HarshHulke77/ESP32-Modbus-MQTT-Gateway/docs/captures/2026-10-23-tx-decoded.png

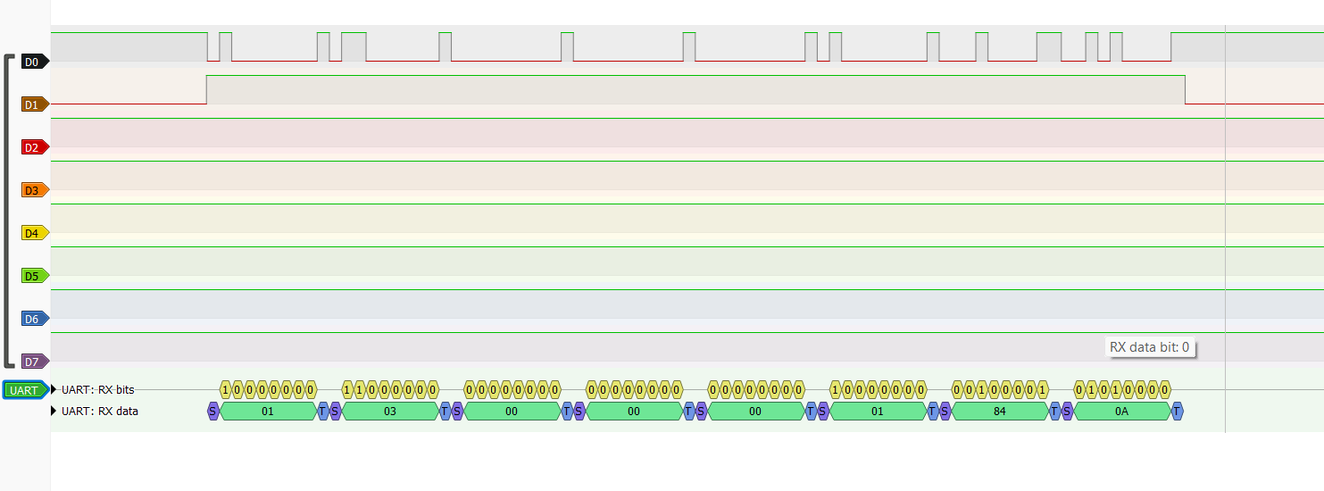
docs/captures/2026-10-23-tx-decoded.png
