HarshHulke77/ESP32-Modbus-MQTT-Gateway/docs/poll-capture1.png

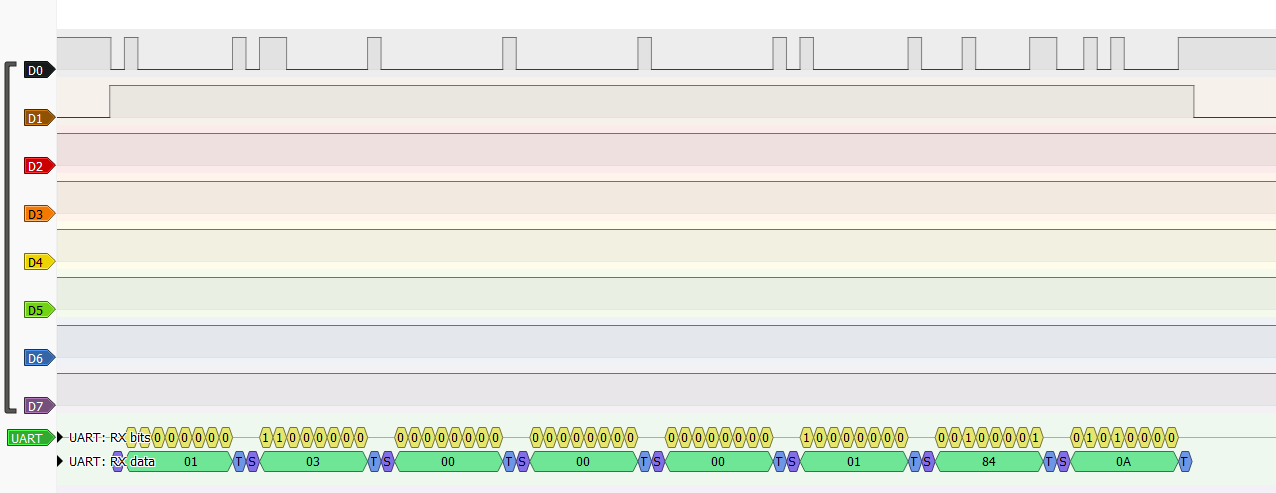
docs/poll-capture1.png
