HarshHulke77/ESP32-Modbus-MQTT-Gateway/docs/bench-log.md

# Bench Log (problems hit and fixes)

## 2026-10-21 - Logic analyzer: "Capture failed, generic/unspecified error"
- Symptom: device detected in PulseView (fx2lafw, D0 to D7 shown) but capture failed.
- Checked: Zadig showed WinUSB already installed on USB ID 0925 3881, so the driver was not the problem.
- Cause: unstable USB port.
- Fix: plugged into a different USB port directly on the laptop. Capture then completed.

## 2026-10-21 - Logic analyzer: D0 flat low on the junction
- Symptom: D0 read low for the whole capture with the CH1 lead on the junction row.
- Cause: ESP32 USB was not plugged in. The MAX485 takes its 5 V from VIN, so it was unpowered and the junction sat at 0 V.
- Fix: power the ESP32 first. Idle junction is about 2.42 V and D0 reads flat high.
- Side note: unconnected channels (D1 to D7) read high by themselves, so "D0 high" alone does not prove contact. Proof of contact: tie CH1 to GND and see D0 go low.

## 2026-10-23 - Arduino IDE 2.x Serial Monitor froze (blank window)
- Symptom: upload succeeded, then the IDE went blank and had to be killed in Task Manager.
- Fix: close the IDE fully, use PuTTY (Serial, CP210x COM port, 115200) instead.

## 2026-10-23 - Gateway TX and DE capture
1 MHz, 5 M samples. D0 = TX (GPIO27), D1 = DE (GPIO4).
DE high at about 100.2 ms, frame about 8.2 ms (expected 8.33 ms), DE low about 0.1 ms after the last bit.
Image: images/2026-10-23-tx-de-capture.png
Note: first capture used 20 kHz by mistake, so the frame was unreadable.

the decoder showed 80 C0 00 00 00 80 21 50 until bit order was changed from msb-first to lsb-first. Same bytes, mirrored, so the wire was fine.
