HarshHulke77/ESP32-Modbus-MQTT-Gateway/docs/captures/500samplestest.png

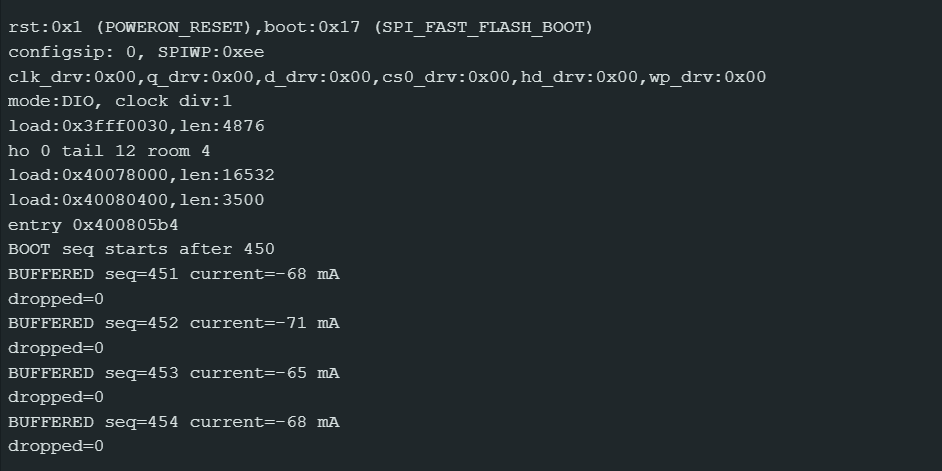
docs/captures/500samplestest.png
