HarshHulke77/ESP32-Modbus-MQTT-Gateway/docs/captures/2026-10-26-request-reply.png

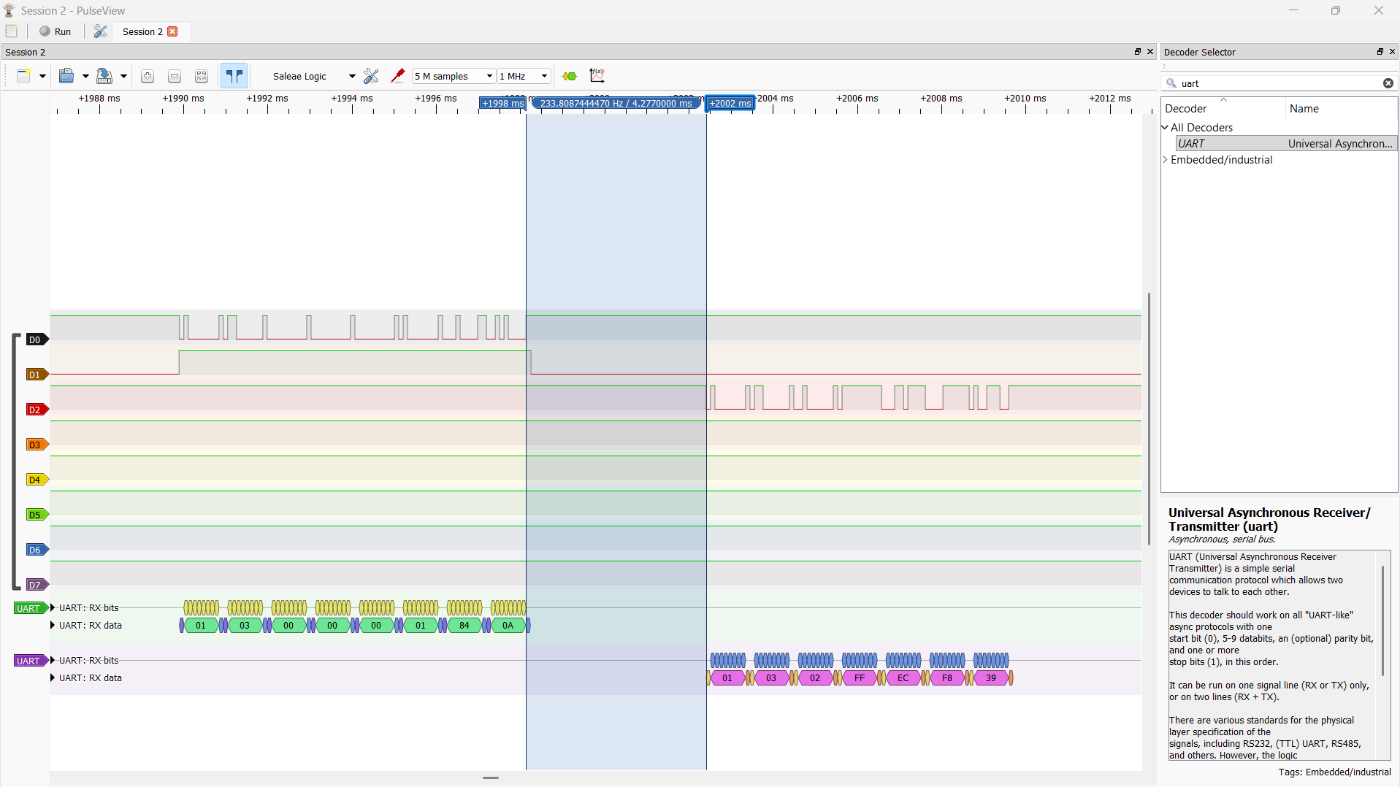
docs/captures/2026-10-26-request-reply.png
