HarshHulke77/ESP32-Modbus-MQTT-Gateway/docs/captures/2026-10-27-fault-rs485-30s.png

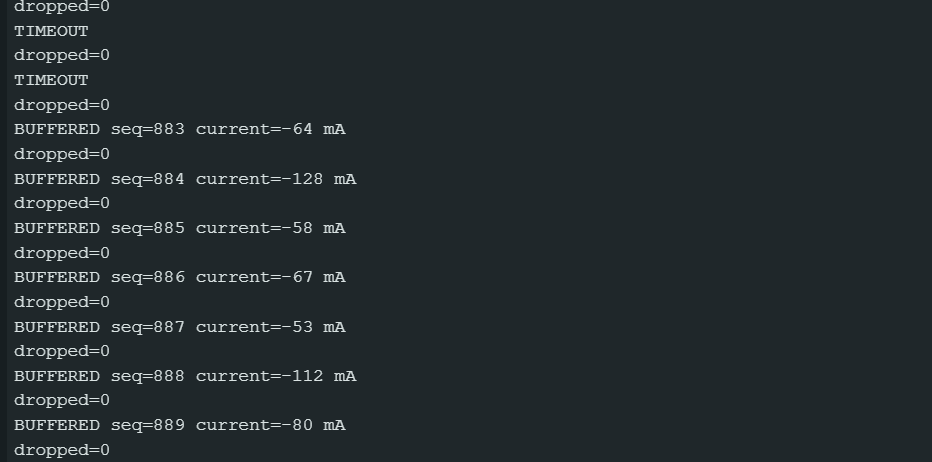
docs/captures/2026-10-27-fault-rs485-30s.png
