HarshHulke77/ESP32-Modbus-MQTT-Gateway/docs/poll-capture2.png

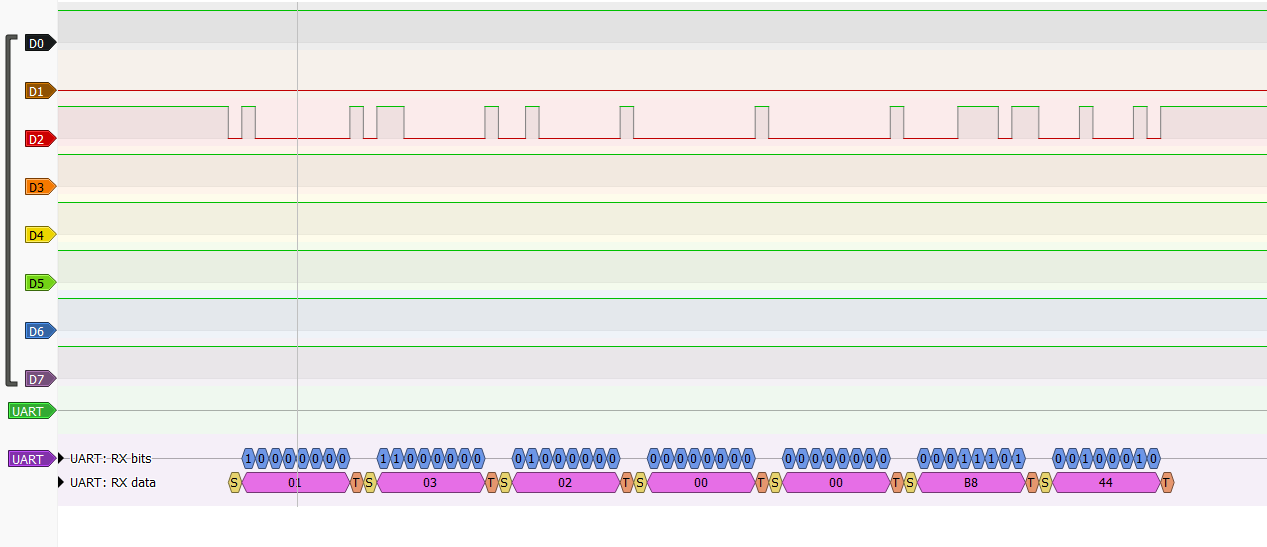
docs/poll-capture2.png
