HarshHulke77/ESP32-Modbus-MQTT-Gateway/docs/2026-10-26-seq-test.png

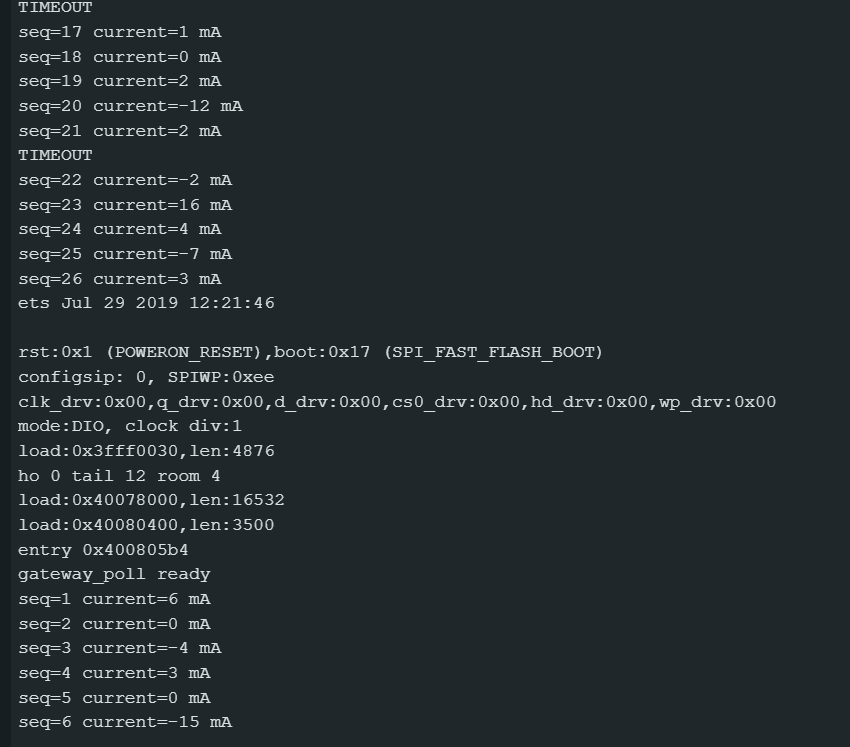
docs/2026-10-26-seq-test.png
