HarshHulke77/ESP32-Modbus-MQTT-Gateway/docs/captures/2026-10-27-mqtt-qos1-test.png

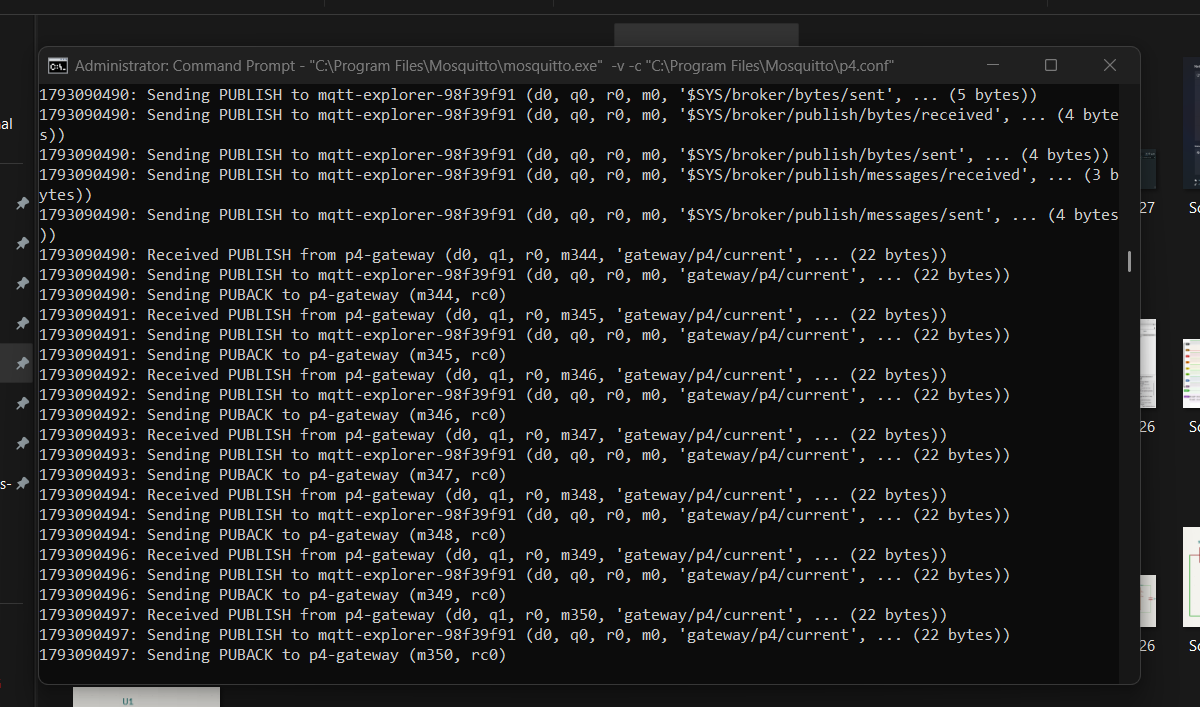
docs/captures/2026-10-27-mqtt-qos1-test.png
