HarshHulke77/ESP32-Modbus-MQTT-Gateway/(commit log)

2026-10-23 Add Tx and DE capture : DE holds until last bit, frame 8.2ms
2026-10-23 Add decoded Tx frame : 01 03 00 00 00 01 84 0A matches expected
2026-10-25 docs: field device ADC zero Capture 2026-10-25
2026-10-25 P4 steps 2-4:field device wired, gateway validates length/ID/CRC
2026-10-26 2026-10-26 - P4 timeout 100 -> 30 ms. A-wire-pull retest passed (TIMEOUT, immediate recovery, no BAD FRAME). Garbage on serial not reproduced, cause unknown.
2026-10-27 Resolved the powercut problem
    [gateway_sf.ino.ino]
2026-10-28 Bug journal: entries 003-007 (broker localhost bind, WiFi reconnect, wiring, leaked credential, stale flash) + open items
